GeorgeCao-001/Robotics-from-Scratch/arduino/MG513XP28_12V_接线指南.md

/*
 * ============================================================
 * 两驱小车完整接线指南
 * ============================================================
 * 电机型号: MG513XP28_12V (WHEELTEC 带霍尔编码器直流减速电机)
 * 驱动模块: TB6612FNG 双路H桥电机驱动 (A口+B口)
 * 电机连接: 左电机→A口, 右电机→B口
 * 控制平台: Arduino UNO
 * ============================================================
 */

/*
 * ------------------------------------------------------------------
 * 一、MG513XP28_12V 电机接口说明
 * ------------------------------------------------------------------
 *
 * MG513XP28_12V 电机为6线集成接口，包含：
 * 
 *  接口序号 | 功能说明       | 典型线色       | 电压等级
 *  --------|---------------|---------------|----------
 *  1       | 电机电源+     | 红色          | 12V
 *  2       | 电机电源-     | 黑色          | GND
 *  3       | 编码器VCC     | 白色/红色     | 3.3V~5V
 *  4       | 编码器GND     | 白色/黑色     | GND
 *  5       | 编码器信号A   | 黄色          | 开漏输出
 *  6       | 编码器信号B   | 绿色/蓝色     | 开漏输出
 *
 * 注意:
 *  - 6线接口为集成设计，无法分离，需整体连接
 *  - 编码器为双端输出(A相+B相)，支持方向检测
 *  - A相用于脉冲计数(外部中断)，B相用于方向判断
 *  - A/B相输出相差90°，A相上升沿时B相电平决定转向:
 *    B=LOW → 正转, B=HIGH → 反转
 *
 * ------------------------------------------------------------------
 * 二、TB6612 双路电机驱动模块说明
 * ------------------------------------------------------------------
 *
 * 模块集成一颗TB6612FNG芯片，提供2个独立电机端口(A/B):
 *
 *   TB6612 (单芯片): 控制A口 + B口
 *
 * 每个端口包含3个控制引脚:
 *   - PWM: 速度控制 (PWM信号)
 *   - IN1: 方向控制1
 *   - IN2: 方向控制2
 *
 * 本项目中:
 *   - 左电机 → 模块A口
 *   - 右电机 → 模块B口
 *
 * TB6612 控制真值表 (单路电机):
 *   IN1  | IN2  | PWM   | 电机状态
 *   -----|------|-------|----------
 *   0    | 0    | X     | 停止(制动)
 *   0    | 1    | 0~255 | 正转
 *   1    | 0    | 0~255 | 反转
 *   1    | 1    | X     | 停止(制动)
 *
 * ------------------------------------------------------------------
 * 三、MG513XP28_12V 与 TB6612 接线表
 * ------------------------------------------------------------------
 *
 *  左电机(L) → 模块A口 (TB6612):
 *
 *  左电机接口    | 模块A口引脚   | Arduino引脚   | 说明
 *  -------------|--------------|--------------|-------------------
 *  电机电源+     | AO1          | -            | 左电机电源正极
 *  电机电源-     | AO2          | -            | 左电机电源负极
 *  编码器VCC     | -            | 5V           | 编码器供电
 *  编码器GND     | -            | GND          | 编码器地
 *  编码器信号A   | -            | D2 (INT0)    | 左编码器A相脉冲
 *  编码器信号B   | -            | A4           | 左编码器B相方向
 *
 *  右电机(R) → 模块B口 (TB6612):
 *
 *  右电机接口    | 模块B口引脚   | Arduino引脚   | 说明
 *  -------------|--------------|--------------|-------------------
 *  电机电源+     | BO1          | -            | 右电机电源正极
 *  电机电源-     | BO2          | -            | 右电机电源负极
 *  编码器VCC     | -            | 5V           | 编码器供电
 *  编码器GND     | -            | GND          | 编码器地
 *  编码器信号A   | -            | D3 (INT1)    | 右编码器A相脉冲
 *  编码器信号B   | -            | A5           | 右编码器B相方向
 *
 *  模块控制信号   | Arduino引脚   | 说明
 *  ---------------|--------------|-------------------
 *  A口 PWMA      | D9 (PWM)     | 左电机PWM (A口)
 *  A口 AIN1      | D7           | 左电机方向1 (A口)
 *  A口 AIN2      | D6           | 左电机方向2 (A口)
 *  B口 PWMB      | D10 (PWM)    | 右电机PWM (B口)
 *  B口 BIN1      | D8           | 右电机方向1 (B口)
 *  B口 BIN2      | D12          | 右电机方向2 (B口)
 *  STBY          | D4           | 待机控制
 *  VCC           | 5V           | 逻辑电源
 *  GND           | GND          | 公共地
 *  VM            | 12V电池正极  | 电机电源输入
 *
 * ------------------------------------------------------------------
 * 四、电路检查清单
 * ------------------------------------------------------------------
 *
 * 【上电前必查】
 *
 * 1. 电源检查:
 *  [ ] 12V电池正极 → 模块VM (仅电机电源)
 *  [ ] 12V电池负极 → 模块GND + Arduino GND (共地)
 *  [ ] Arduino 5V → 模块VCC (逻辑电源)
 *  [ ] 严禁将12V接入Arduino 5V引脚
 *
 * 2. 电机输出检查:
 *  [ ] 左电机+ → 模块A口 AO1
 *  [ ] 左电机- → 模块A口 AO2
 *  [ ] 右电机+ → 模块B口 BO1
 *  [ ] 右电机- → 模块B口 BO2
 *  [ ] 电机线无短路 (万用表测量AO1-AO2、BO1-BO2)
 *
 * 3. 编码器检查:
 *  [ ] 左编码器VCC → Arduino 5V
 *  [ ] 左编码器GND → Arduino GND
 *  [ ] 左编码器信号A → Arduino D2
 *  [ ] 左编码器信号B → Arduino A4
 *  [ ] 右编码器VCC → Arduino 5V
 *  [ ] 右编码器GND → Arduino GND
 *  [ ] 右编码器信号A → Arduino D3
 *  [ ] 右编码器信号B → Arduino A5
 *
 * 4. 控制信号检查:
 *  [ ] PWMA (D9) → 模块A口 PWMA
 *  [ ] AIN1 (D7) → 模块A口 AIN1
 *  [ ] AIN2 (D6) → 模块A口 AIN2
 *  [ ] PWMB (D10) → 模块B口 PWMB
 *  [ ] BIN1 (D8) → 模块B口 BIN1
 *  [ ] BIN2 (D12) → 模块B口 BIN2
 *  [ ] STBY (D4) → 模块STBY
 *
 * 5. 共地检查:
 *  [ ] 模块GND ↔ Arduino GND ↔ 电池负极 (必须全部连通)
 *
 * ------------------------------------------------------------------
 * 五、接线验证步骤
 * ------------------------------------------------------------------
 *
 * 步骤1: 电源验证 (仅接电源, 不接电机)
 *   - 万用表测量模块VM-GND: 应显示12V左右
 *   - 万用表测量模块VCC-GND: 应显示5V
 *   - 确认无短路后进行下一步
 *
 * 步骤2: 编码器信号验证 (接编码器, 手转电机)
 *   - 将编码器A相信号引脚连接到Arduino D2/D3
 *   - 将编码器B相信号引脚连接到Arduino A4/A5
 *   - 手转电机轴, 用示波器或串口打印观察脉冲
 *   - 确认A相有脉冲输出
 *   - 确认A/B相相位差约90° (正转时A超前B, 反转时B超前A)
 *
 * 步骤3: 电机驱动验证 (电机悬空)
 *   - 上传测试程序, 发送命令使电机转动
 *   - 观察电机转向是否正确
 *   - 确认两个电机独立可控
 *
 * 步骤4: 闭环控制验证
 *   - 运行完整程序, 观察编码器读数
 *   - 确认PID控制正常工作
 *
 * ------------------------------------------------------------------
 * 六、驱动程序配置建议
 * ------------------------------------------------------------------
 *
 * MG513XP28_12V 电机关键参数 (需根据实际型号调整):
 * 
 *  电机参数       | 典型值       | 说明
 *  -------------|-------------|-------------------
 *  额定电压      | 12V         | 锂电池组供电
 *  减速比        | 1:28/1:30   | 常见配置, 影响转速
 *  编码器线数    | 11线        | 霍尔编码器分辨率
 *  编码器脉冲/圈 | 11 (A相上升沿) | 单倍频计数
 *
 * 程序配置建议:
 *
 * 1. 修改编码器脉冲数:
 *    #define ENCODER_PPR     11    // A相上升沿计数 (单倍频)
 *
 * 2. 调整PID参数 (MG513电机响应特性):
 *    #define VELOCITY_KP     18.0f  // 比例系数
 *    #define VELOCITY_KI     8.0f   // 积分系数
 *
 * 3. 调整默认速度:
 *    #define DEFAULT_SPEED   25     // 编码器脉冲/5ms
 *    #define DEFAULT_TURN    15     // 转向差速
 *
 * 4. 电机方向调整:
 *    如果电机转向相反, 可交换电机线(M+/M-)或修改代码:
 *    在setMotorPwm()函数中交换IN1/IN2的高低电平
 *
 * ------------------------------------------------------------------
 * 七、常见问题排查
 * ------------------------------------------------------------------
 *
 * 问题1: 电机不转
 *   - 检查STBY引脚是否为HIGH
 *   - 检查电机线连接是否正确 (左电机→A口, 右电机→B口)
 *   - 检查12V电源是否正常
 *   - 检查TB6612的STBY是否已拉高
 *
 * 问题2: 编码器无读数
 *   - 检查编码器VCC/GND连接
 *   - 检查信号引脚是否正确连接到D2/D3
 *   - 手转电机轴, 用示波器观察脉冲
 *
 * 问题3: 电机抖动或噪音大
 *   - 检查PID参数是否合适
 *   - 检查电源是否稳定 (加滤波电容)
 *   - 检查电机机械安装是否牢固
 *
 * 问题4: 小车走偏
 *   - 检查两个电机参数是否一致
 *   - 调整PID参数使转速匹配
 *   - 检查车轮安装是否对称
 *
 * ------------------------------------------------------------------
 * 八、接线示意图 (文字版)
 * ------------------------------------------------------------------
 *
 * 电源部分:
 *   [12V锂电池] ──→ [模块VM]
 *   [12V锂电池] ──→ [Arduino VIN] (可选)
 *   [电池负极] ──→ [模块GND] ──→ [Arduino GND]
 *
 * 左电机 → 模块A口:
 *   [左电机6线接口]
 *     ├─ 电机+ ──→ [模块A口 AO1]
 *     ├─ 电机- ──→ [模块A口 AO2]
 *     ├─ 编码器VCC ──→ [Arduino 5V]
 *     ├─ 编码器GND ──→ [Arduino GND]
 *     ├─ 编码器A相 ──→ [Arduino D2]
 *     └─ 编码器B相 ──→ [Arduino A4]
 *
 * 右电机 → 模块B口:
 *   [右电机6线接口]
 *     ├─ 电机+ ──→ [模块B口 BO1]
 *     ├─ 电机- ──→ [模块B口 BO2]
 *     ├─ 编码器VCC ──→ [Arduino 5V]
 *     ├─ 编码器GND ──→ [Arduino GND]
 *     ├─ 编码器A相 ──→ [Arduino D3]
 *     └─ 编码器B相 ──→ [Arduino A5]
 *
 * 控制信号:
 *   [Arduino D9]  ──→ [模块A口 PWMA]
 *   [Arduino D7]  ──→ [模块A口 AIN1]
 *   [Arduino D6]  ──→ [模块A口 AIN2]
 *   [Arduino D10] ──→ [模块B口 PWMB]
 *   [Arduino D8]  ──→ [模块B口 BIN1]
 *   [Arduino D12] ──→ [模块B口 BIN2]
 *   [Arduino D4]  ──→ [模块STBY]
 *   [Arduino 5V]  ──→ [模块VCC]
 *
 * ------------------------------------------------------------------
 * 九、12V锂电池组电源接入
 * ------------------------------------------------------------------
 *
 * 电源拓扑:
 *
 *   [12V锂电池组]
 *        |
 *        +----→ 模块VM (电机电源, 12V)
 *        |
 *        +----→ Arduino VIN (通过Arduino板载稳压器降压到5V)
 *        |      或通过USB单独供电Arduino
 *        |
 *        +----→ GND (共地!!!)
 *
 * 供电方案 (推荐方案A):
 *
 *   方案A: 12V电池同时供电Arduino和模块
 *     - 12V电池正极 → 模块VM
 *     - 12V电池正极 → Arduino VIN (板载稳压器降压到5V)
 *     - 12V电池负极 → 模块GND + Arduino GND (共地)
 *     - Arduino 5V → 模块VCC (逻辑电源)
 *
 *   方案B: 12V电池供电模块, USB供电Arduino (调试推荐)
 *     - 12V电池正极 → 模块VM
 *     - 12V电池负极 → 模块GND
 *     - Arduino USB供电
 *     - Arduino 5V → 模块VCC
 *     - 模块GND ↔ Arduino GND (必须共地!!!)
 *
 * 注意事项:
 *   1. 12V电池组务必使用3S锂电池(标称11.1V, 满电12.6V)
 *   2. 模块VM最高耐压15V, 3S锂电池安全可用
 *   3. 严禁将12V直接接入Arduino 5V引脚, 会烧毁芯片!
 *   4. 必须确保所有GND共地, 否则信号无法正常传输
 *   5. 建议在VM和GND之间并联100μF~470μF电解电容, 吸收电机反电动势
 *   6. 电池正极建议串联5A保险丝, 防止短路
 *   7. 首次上电前用万用表确认无短路
 *
 * ------------------------------------------------------------------
 * 十、万向轮机械安装简要说明
 * ------------------------------------------------------------------
 *
 * 三轮结构布局 (俯视图):
 *
 *          [万向轮]
 *             |
 *     --------O--------    ← 前部
 *     |                |
 *     |    车体底盘    |
 *     |                |
 *     -----O-----O----    ← 后部
 *        [左轮] [右轮]
 *
 * 安装要点:
 *   1. 万向轮安装在车体前部中央, 作为从动支撑轮
 *   2. 两个驱动轮安装在车体后部左右两侧
 *   3. 万向轮高度需与驱动轮在同一水平面, 确保车体平稳
 *   4. 万向轮选用球型或牛眼轮(ball caster), 摩擦力小
 *   5. 驱动轮轴心连线应与万向轮安装点形成等腰三角形
 *   6. 重心应尽量靠近驱动轮轴心连线, 避免万向轮承重过大
 *   7. 万向轮安装座需有足够强度, 推荐使用金属支架
 *   8. 建议在万向轮与底盘之间加装弹簧或橡胶垫, 吸收震动
 *
 * ------------------------------------------------------------------
 * 十一、首次运行步骤
 * ------------------------------------------------------------------
 *
 *  1. 仅通过USB连接Arduino到电脑 (不接12V电池)
 *  2. 上传程序到Arduino UNO
 *  3. 打开串口监视器 (波特率115200)
 *  4. 确认看到初始化信息
 *  5. 断开USB, 按接线图连接12V电池
 *  6. 将小车悬空 (车轮离地), 重新连接USB
 *  7. 在串口发送 'w' 命令, 观察车轮是否转动
 *  8. 确认两个车轮转动方向正确 (都向前转)
 *  9. 如果某车轮反转, 交换该电机M+/M-接线
 *  10. 确认编码器读数正常 (串口会打印编码器值)
 *  11. 所有测试通过后, 将小车放置地面运行
 *
 * ============================================================
 */
