GeorgeCao-001/Robotics-from-Scratch/arduino/logs/changelog/2026-05-12/wiring_guide.md

================================================================================
  遥控器系统接线指南 - 每日更新日志
================================================================================

项目名称: 遥控器系统接线指南 (遥控器系统接线指南.md)
版本号:   v2.0.0
更新日期: 2026-05-12

================================================================================
一、主要更新内容
================================================================================

【新增内容】
  - 新增控制方式说明: 左摇杆Y轴=速度、右摇杆X轴=方向、模式按键=手动/自动
  - 新增摇杆单轴接线说明(左摇杆仅Y轴、右摇杆仅X轴，其余悬空)
  - 新增控制模式详细说明章节(第八节)
    - 手动控制模式操作说明
    - 自动运行模式操作说明
    - LED状态指示含义
  - 新增自动模式故障排除条目
  - 新增UART协议示例(含自动模式示例: "$V0,T0,F1*\n")

【优化项】
  - 元件清单精简: 移除SG90/MG90S舵机、4个按键减为1个、移除蜂鸣器
  - ESP32-S3接线表精简: 从12个引脚减至6个
  - ESP32-C3接线表精简: 移除舵机引脚(GPIO7/GPIO8)和电池ADC(GPIO0)
  - ESP-NOW数据包格式图更新为6字节
  - UART协议格式更新: 移除S字段
  - 测试步骤更新: 增加模式切换测试、移除云台测试
  - 系统架构图更新: 反映新的控制方式

【移除内容】
  - 移除云台舵机相关接线说明(GPIO7/GPIO8)
  - 移除急停/加速/减速按键接线说明
  - 移除蜂鸣器接线说明
  - 移除ESP32-C3电池ADC检测电路说明
  - 移除云台测试步骤(阶段5)
  - 移除舵机抖动故障排除条目
  - 移除旧版9字节数据包格式图

================================================================================
二、影响范围
================================================================================

  文档影响:
    - 接线指南全面重写，与v1.x内容差异较大
    - 硬件搭建需完全参照v2.0版本

  硬件搭建影响:
    - 遥控器元件数量减少，组装更简单
    - ESP32-C3接线更简单(仅需4线)
    - 不再需要舵机供电考虑

================================================================================
三、兼容性说明
================================================================================

  文档兼容: 仅适用于v2.0.0固件
    - v1.x固件请参照旧版接线指南
    - 固件与接线指南版本必须匹配

  硬件参考:
    - ESP32-S3 DevKitC: 引脚定义适用
    - ESP32-C3 SuperMini: 引脚定义适用
    - KY-023摇杆模块: 接线方式适用(单轴接法)

================================================================================
四、已知问题
================================================================================

  1. 左摇杆VRx和右摇杆VRy悬空可能导致ADC输入浮动，
     建议在PCB设计时将未用ADC引脚接地或接3.3V

  2. 文档中ESP32-C3的电池电压检测已移除，
     但StatusPacket中仍有batteryVx10字段，
     该字段当前回传固定值，后续版本需补充说明

  3. 1kΩ串联电阻保护ESP32-C3 RX引脚的说明较为简略，
     建议后续版本增加电路原理图

================================================================================
