GeorgeCao-001/Robotics-from-Scratch/arduino/logs/changelog/2026-05-14/wiring_guide.md

================================================================================
  项目文档 - 每日更新日志
================================================================================

项目名称: 技术文档与遥控器系统接线指南 (技术文档.md / 遥控器系统接线指南.md)
版本号:   v2.2.0
更新日期: 2026-05-14

================================================================================
一、主要更新内容
================================================================================

【修复的问题】
  - 修正文档中"收到普通遥控指令后自动切换到遥控器模式"的旧描述
    现统一更正为: 仅在用户按下模式键并发送显式切换请求时才执行模式切换

  - 修正文档中flags字段的旧定义
    原说明为"bit0=自动模式"
    现更新为"bit0=当前模式, bit1=模式切换请求"

  - 修正UART协议示例中的旧模式切换写法
    旧示例: "$V0,T0,F1*\n"
    新示例: "$V0,T0,F3*\n" (切换到自动模式)
            "$V0,T0,F2*\n" (切换到手动模式)

【优化项】
  - 技术文档中的三模式控制系统说明与最新主控实现保持一致
  - 遥控器系统接线指南补充"自动模式下拨动摇杆不会自动切回手动"测试项
  - 两份文档的协议术语、模式定义与示例格式已统一

================================================================================
二、影响范围
================================================================================

  文档影响:
    - 技术文档中的协议说明、模式流转图、解析逻辑说明已同步更新
    - 遥控器系统接线指南中的协议图示、操作说明、测试步骤已同步更新

  使用影响:
    - 使用者可准确区分"当前模式状态"与"模式切换请求"
    - 调试与联调时可直接依据新flags示例定位模式切换问题

================================================================================
三、兼容性说明
================================================================================

  文档适用范围:
    - 适用于遥控器v2.1.0与Arduino主控v2.1.0的组合
    - ESP32-C3接收器v2.0.x/v2.1.x均可参考相同协议说明

  版本建议:
    - 若项目仍停留在v2.0.x，请勿直接套用本次模式切换示例
    - 建议代码与文档同步升级，避免调试时出现认知偏差

================================================================================
四、已知问题
================================================================================

  (无新增)

================================================================================
五、v2.2.0 追加更新 (2026-05-14)
================================================================================

【修复的问题】
  - 修正遥控器系统接线指南中UART协议回传格式描述
    原描述: "#E<encL>,<encR>,<pwmA>,<pwmD>,\n"
    现更正: "#E<encL>,<encR>,<pwmA>,<pwmB>,\n"
    与主控代码中motorPwmB变量命名保持一致

================================================================================
六、v2.3.0 追加更新 (2026-05-14)
================================================================================

【新增内容】
  - 接线指南全面更新为6线编码器接口
    新增编码器B相信号线(序号6, 绿色/蓝色)
  - 接线表新增B相行: 左编码器B→A4, 右编码器B→A5
  - 电路检查清单新增B相连接检查项
  - 接线验证步骤新增A/B相相位差验证
  - 接线示意图从5线更新为6线

【修复的问题】
  - 修正编码器脉冲/圈说明
    原说明"44 (11×4) 4倍频后脉冲数"与实际1倍频计数不一致
    现修正为"11 (A相上升沿) 单倍频计数"

【优化项】
  - 遥控器系统接线指南Arduino引脚分配表新增A4/A5编码器B相行
  - D2/D3功能描述从"编码器左/右"更精确为"编码器左A相/右A相"

================================================================================
