GeorgeCao-001/Robotics-from-Scratch/arduino/logs/changelog/2026-05-13/wiring_guide.md

================================================================================
  接线指南文档 - 每日更新日志
================================================================================

项目名称: 两驱小车完整接线指南 (MG513XP28_12V_接线指南.md)
版本号:   v2.0.1
更新日期: 2026-05-13

================================================================================
一、主要更新内容
================================================================================

【新增内容】
  - 合并接线指导.md的3节唯一内容至本文档:
    九、12V锂电池组电源接入 (含电源拓扑、方案A/B、7条注意事项)
    十、万向轮机械安装简要说明 (含三轮布局图、8条安装要点)
    十一、首次运行步骤 (11步首次运行流程)

【优化项】
  - 文件标题从"MG513XP28_12V 电机 - WHEELTEC四路TB6612 驱动接线指南"
    更新为"两驱小车完整接线指南"，更准确反映综合接线文档定位
  - 章节编号从8节扩展为11节，结构更完整

【移除内容】
  - 删除冗余文件 接线指导.md (内容已合并至本文档)

================================================================================
二、影响范围
================================================================================

  文档影响:
    - 接线指导.md已删除，所有接线信息统一由MG513XP28_12V_接线指南.md提供
    - 文档从8节(250行)扩展为11节(329行)

  开发影响:
    - 开发人员仅需查阅一个接线文档，避免信息分散和版本不一致

================================================================================
三、兼容性说明
================================================================================

  技术内容: 与v2.0.0完全一致
    - 引脚分配、接线方式、电机连接均无变更
    - 新增内容来自已删除的接线指导.md，为原有内容的迁移

================================================================================
四、已知问题
================================================================================

  (无新增)

================================================================================
