GeorgeCao-001/Robotics-from-Scratch/arduino/logs/changelog/2026-05-16/daily_summary.md

================================================================================
  项目每日工作总结日志
================================================================================

项目名称: Arduino TB6612 两驱小车 + 树莓派4B视觉跟随系统
工作日期: 2026-05-16
记录时间: 2026-05-16

================================================================================
一、今日完成任务总览
================================================================================

  | 序号 | 任务名称 | 状态 | 优先级 |
  |------|---------|------|--------|
  | 1 | 遥控模式转向方向修正 | ✅ 完成 | 高 |
  | 2 | 遥控模式转向速度调整 | ✅ 完成 | 高 |
  | 3 | 树莓派4B硬件连接方案设计 | ✅ 完成 | 高 |
  | 4 | Arduino端树莓派自动模式实现 | ✅ 完成 | 高 |
  | 5 | 树莓派端代码适配与模式切换 | ✅ 完成 | 高 |
  | 6 | 失控急停多层保护完善 | ✅ 完成 | 高 |
  | 7 | 技术文档全面更新 | ✅ 完成 | 高 |
  | 8 | 更新日志创建 | ✅ 完成 | 中 |

================================================================================
二、任务详细记录
================================================================================

  ──────────────────────────────────────────
  任务1: 遥控模式转向方向修正
  ──────────────────────────────────────────
  开始时间: 2026-05-16 上午
  结束时间: 2026-05-16 上午
  任务成果:
    - 在applyRemoteDrive()中添加 steerPercent = -steerPercent
    - 遥控器向左操作→小车左转，向右操作→小车右转
  实施步骤:
    1. 分析转向方向反转的根本原因：摇杆映射百分比与差速驱动方向定义相反
    2. 在applyRemoteDrive()中转向百分比取反
    3. 实际操作测试验证方向正确性
  遇到问题: 无
  解决方案: N/A
  使用技术/工具: C++、Arduino IDE

  ──────────────────────────────────────────
  任务2: 遥控模式转向速度调整
  ──────────────────────────────────────────
  开始时间: 2026-05-16 上午
  结束时间: 2026-05-16 上午
  任务成果:
    - REMOTE_TURN_PWM_MAX从200降低到80
    - 转向速度平稳可控，不再过快
  实施步骤:
    1. 确认转向速度过快的根本原因：PWM上限过高
    2. 逐步降低PWM上限，从200→120→80，测试转向手感
    3. 最终确定80为最佳值，转向平稳且响应灵敏
  遇到问题: 初始尝试120仍然偏快
  解决方案: 继续降低到80，达到理想手感
  使用技术/工具: C++、Arduino IDE、实际操作测试

  ──────────────────────────────────────────
  任务3: 树莓派4B硬件连接方案设计
  ──────────────────────────────────────────
  开始时间: 2026-05-16 上午
  结束时间: 2026-05-16 下午
  任务成果:
    - USB串口直连方案: 树莓派USB-A → Arduino UNO USB-B
    - 不占用任何Arduino已有引脚
    - 云台舵机连接树莓派GPIO17(水平)/GPIO27(垂直)
    - 供电方案: 2S电池→UBEC(5V/3A)→树莓派，与Arduino共地
  实施步骤:
    1. 盘点Arduino UNO已占用引脚(D2~D13, A0~A5全部已用)
    2. 确认USB CDC虚拟串口方案无需额外引脚
    3. 设计树莓派GPIO引脚分配(BCM17/27用于舵机PWM)
    4. 设计供电方案(UBEC降压，避免树莓派USB供电不足)
    5. 编写详细硬件连接文档
  遇到问题: Arduino引脚全部已占用，无法使用UART/I2C/SPI
  解决方案: 利用USB CDC虚拟串口，无需额外引脚
  使用技术/工具: USB CDC协议、RPi.GPIO、UBEC降压模块

  ──────────────────────────────────────────
  任务4: Arduino端树莓派自动模式实现
  ──────────────────────────────────────────
  开始时间: 2026-05-16 下午
  结束时间: 2026-05-16 下午
  任务成果:
    - 新增CTRL_MODE_RPI_AUTO(3)控制模式
    - 实现parseRpiCommand() JSON指令解析
    - 实现JSON缓冲区机制(64字节)
    - 实现checkRpiTimeout()超时检测(1000ms)
    - handleSerialCommand()重构为双通道处理
  实施步骤:
    1. 定义CTRL_MODE_RPI_AUTO常量和相关全局变量
    2. 实现JSON缓冲区逐字符接收逻辑
    3. 实现parseRpiCommand()解析move/mode/estop/stop四种指令
    4. 实现v/w归一化值到Arduino速度/转向脉冲的映射
    5. 实现checkRpiTimeout()超时停车检测
    6. 修改handleSerialCommand()支持单字符和JSON双通道
    7. 修改parseRemoteCommand()支持RPI_AUTO模式切换
  遇到问题:
    - JSON解析与单字符命令共存需要区分机制
  解决方案:
    - 以'{'开头识别JSON指令，其他为单字符命令
    - 仅在RPI_AUTO模式下解析JSON，其他模式仅处理单字符
  使用技术/工具: C++、Arduino串口编程、JSON简易解析(strstr)

  ──────────────────────────────────────────
  任务5: 树莓派端代码适配与模式切换
  ──────────────────────────────────────────
  开始时间: 2026-05-16 下午
  结束时间: 2026-05-16 下午
  任务成果:
    - main.py启动流程增加mode:rpi_auto切换指令
    - main.py退出流程增加mode:remote恢复指令
    - serial_comm.py新增mode和estop指令验证
    - 所有退出操作用try/except包裹确保资源释放
  实施步骤:
    1. 在main.py的run()函数中添加启动模式切换
    2. 在main.py的finally块中添加退出模式恢复
    3. 在serial_comm.py的_validate_message()中添加mode/estop验证
    4. 测试启动/退出流程的可靠性
  遇到问题: 退出时串口可能已断开导致发送失败
  解决方案: 所有退出操作用try/except包裹，不阻塞后续资源清理
  使用技术/工具: Python、pyserial、RPi.GPIO

  ──────────────────────────────────────────
  任务6: 失控急停多层保护完善
  ──────────────────────────────────────────
  开始时间: 2026-05-16 下午
  结束时间: 2026-05-16 下午
  任务成果:
    - 建立6层失控急停保护体系:
      1. 树莓派超时急停(1000ms)
      2. 视觉丢失停车(0.8s)
      3. 遥控器急停(模式键)
      4. USB串口急停(空格/estop)
      5. 树莓派退出(finally块)
      6. 树莓派断电(USB断开)
    - 明确保护优先级: estop > 遥控器 > 超时 > 视觉丢失
    - 区分"切换模式"和"仅停车"两种响应级别
  实施步骤:
    1. 梳理所有可能的失控场景
    2. 为每种场景设计检测机制和响应策略
    3. 确定保护优先级和恢复方式
    4. 在代码中实现各层保护逻辑
  遇到问题: 超时停车后是否应切换模式
  解决方案: 超时和视觉丢失仅停车不切换模式，允许自动恢复；
           estop和遥控器模式键切换模式，需手动恢复
  使用技术/工具: C++、Python、millis()超时检测

  ──────────────────────────────────────────
  任务7: 技术文档全面更新
  ──────────────────────────────────────────
  开始时间: 2026-05-16 下午
  结束时间: 2026-05-16 晚间
  任务成果:
    - 新增2.5硬件连接方案章节(5个子章节)
    - 新增2.6树莓派端代码解析章节(5个子章节)
    - 更新项目目标、功能模块图、模式控制、JSON解析、安全保护等章节
    - 修正转向PWM上限值(120→80)
    - 术语表新增8个术语
    - 学习路径新增"阶段5: 视觉跟随"
    - 知识点对照表新增3行
    - 版本迭代记录更新至v2.2.0
  实施步骤:
    1. 审查现有文档，识别与代码不一致的章节
    2. 审查所有源代码文件，确认最新实现状态
    3. 更新系统架构与模式控制章节
    4. 更新串口通信协议与JSON指令解析章节
    5. 更新失控急停保护章节
    6. 新增树莓派端代码解析章节
    7. 更新硬件连接方案章节
    8. 更新使用说明与操作指南
    9. 同步更新变更日志与术语表
    10. 最终一致性校验(常量值、模式编号、命名)
  遇到问题:
    - 文档中REMOTE_TURN_PWM_MAX值(120)与代码(80)不一致
    - 2.4模块交互逻辑标题被误删
  解决方案:
    - 修正文档中的PWM上限值为80
    - 恢复2.4标题
  使用技术/工具: Markdown、代码审查

================================================================================
三、遇到的问题及解决方案汇总
================================================================================

  | 问题 | 影响 | 解决方案 | 状态 |
  |------|------|---------|------|
  | 遥控模式转向方向相反 | 操作直觉不符 | applyRemoteDrive()中steerPercent取反 | ✅ |
  | 转向速度过快 | 操控不稳定 | REMOTE_TURN_PWM_MAX从200降到80 | ✅ |
  | Arduino引脚全部已占用 | 无法用UART/I2C连接树莓派 | 使用USB CDC虚拟串口 | ✅ |
  | JSON与单字符命令共存 | 串口命令解析冲突 | 以'{'开头区分JSON，模式分流 | ✅ |
  | 退出时串口可能已断开 | 模式恢复指令发送失败 | try/except包裹，不阻塞清理 | ✅ |
  | 文档PWM上限值不一致 | 文档误导 | 修正为与代码一致的80 | ✅ |
  | 2.4标题被误删 | 文档结构不完整 | 恢复### 2.4标题 | ✅ |

================================================================================
四、未完成事项及原因分析
================================================================================

  (无未完成事项)

  今日计划的所有任务均已完成。

================================================================================
五、技术决策记录
================================================================================

  1. USB串口 vs GPIO串口连接树莓派
     决策: 使用USB CDC虚拟串口
     原因: Arduino UNO所有引脚已占用，USB串口无需额外引脚；
           115200bps速率充足，USB CDC稳定性优于SoftwareSerial

  2. JSON简易解析 vs ArduinoJson库
     决策: 使用strstr()简易解析
     原因: Arduino UNO RAM仅2KB，ArduinoJson库占用较多内存；
           当前指令格式均为扁平结构，strstr()足够

  3. 超时停车是否切换模式
     决策: 超时和视觉丢失仅停车不切换模式
     原因: 允许树莓派恢复后自动继续控制，避免频繁模式切换；
           estop和遥控器模式键切换模式，用于需要手动接管的场景

  4. 转向PWM上限值选择
     决策: REMOTE_TURN_PWM_MAX = 80
     原因: 120仍偏快，80在测试中达到平稳可控的转向手感；
           远低于驱动PWM上限220，确保转向不会过于剧烈

================================================================================
六、明日工作计划
================================================================================

  1. 树莓派自动模式实车联调测试
     - 验证USB串口通信稳定性
     - 验证视觉跟随效果
     - 验证6层急停保护的实际响应

  2. 参数微调
     - 根据实车测试结果调整PlanningConfig参数
     - 可能需要调整kp_angle/kp_distance/v_max/w_max

  3. 补充实物接线照片到技术文档
     - 拍摄树莓派与Arduino的USB连接
     - 拍摄云台舵机接线
     - 拍摄UBEC供电接线

  4. 性能优化（如需要）
     - 评估MediaPipe在树莓派4B上的实际帧率
     - 评估是否需要降低模型复杂度

================================================================================
七、工作时长统计
================================================================================

  | 任务类别 | 预估时长 | 实际时长 |
  |---------|---------|---------|
  | 遥控模式调试 | 1h | 1h |
  | 硬件方案设计 | 2h | 2h |
  | Arduino代码开发 | 3h | 3h |
  | 树莓派代码适配 | 1h | 1h |
  | 安全保护完善 | 1h | 1h |
  | 技术文档更新 | 3h | 3h |
  | 更新日志编写 | 1h | 1h |
  | 合计 | 12h | 12h |

================================================================================
