GeorgeCao-001/Robotics-from-Scratch/arduino/logs/changelog/2026-05-16/documentation.md

================================================================================
  项目技术文档 - 每日更新日志
================================================================================

项目名称: 技术文档 (技术文档.md)
版本号:   v2.2.0
更新日期: 2026-05-16

================================================================================
一、主要更新内容
================================================================================

【新增章节】

  1. 2.5 树莓派4B硬件连接方案
     - USB串口直连方案: 树莓派4B USB-A → Arduino UNO USB-B
     - 引脚分配表: 树莓派GPIO17(水平舵机)/GPIO27(垂直舵机)/USB串口
     - 供电方案: 2S锂电池→UBEC(5V/3A)→树莓派4B，与Arduino共地
     - 通信协议: JSON over Serial, 115200bps, '\n'分隔
     - 接线注意事项: USB数据线要求、共地连接、舵机供电隔离

  2. 2.6 树莓派端代码解析
     - 2.6.1 项目结构: 目录树 + 各模块职责说明
     - 2.6.2 串口通信模块: SerialComm类、参数选择依据、白名单验证、发送流程
     - 2.6.3 云台控制模块: GimbalHardware类、角度→占空比映射推导、舵机PWM原理
     - 2.6.4 规划模块: PlanningConfig参数、P控制设计理由、Planner协调器、
       FollowController(v/w计算)、GimbalController(增量式控制)
     - 2.6.5 主程序生命周期: 线程模型、分线程原因、命令行参数

【更新章节】

  1. 项目目标
     - 新增"视觉跟随"目标: 树莓派4B + 摄像头实现人体检测与自动跟随
     - 新增"云台控制"目标: 树莓派GPIO PWM驱动双轴云台，摄像头始终对准目标
     - 新增"安全保护"目标: 电池低压保护、遥控器断连自动停车、树莓派超时急停、视觉丢失停车

  2. 系统功能模块图
     - 新增树莓派相关模块: 摄像头、视觉处理(MediaPipe Pose)、
       USB串口通信、云台PWM控制

  3. 模式控制章节
     - "三模式控制系统"更新为"四模式控制系统"
     - 新增树莓派自动模式(编号3): 触发方式、行为描述、切换逻辑
     - 更新模式切换流程图: 包含自动模式的进入和退出路径

  4. 2.3.4 JSON指令解析
     - 新增parseRpiCommand()完整代码解析
     - 新增JSON缓冲区机制说明(rpiBuf[64], 逐字符接收, '\n'分隔)
     - 新增v/w→Arduino速度映射公式:
       velocity = v × REMOTE_SPEED_MAX (40脉冲/5ms)
       turn = w × DEFAULT_TURN (18脉冲/5ms)
     - 新增超时检测checkRpiTimeout()说明

  5. 2.4.3 树莓派自动模式流程
     - 扩展为启动阶段+退出阶段双流程图
     - 新增启动/退出关键设计说明(先停车再切换模式、try/except包裹)
     - 安全保护表从5层扩展为6层(新增"树莓派断电"保护)
     - 新增"恢复方式"列和"保护优先级"说明

  6. 目录
     - 新增2.5和2.6章节链接

  7. 术语表
     - 新增8个术语: P控制、JSON、MediaPipe、BCM编号、USB CDC、UBEC、指数平滑、daemon线程
     - 修正PWM解释: "控制电机平均电压" → "控制电机平均电压或舵机角度"

  8. 学习路径
     - 新增"阶段5: 视觉跟随 (2~3周)"含5个子项

  9. 知识点对照表
     - 新增3行: 视觉检测(MediaPipe Pose)、嵌入式Python(树莓派)、舵机控制(GPIO PWM)
     - 通信协议更新: ESP-NOW+UART → ESP-NOW+UART+USB Serial

【修正项】

  1. 修正转向PWM上限值: 120 → 80 (与代码REMOTE_TURN_PWM_MAX=80一致)
  2. 修正版本记录v2.1.2: "200→120" → "200→80"
  3. 恢复2.4模块交互逻辑标题(此前被误删)
  4. 修正遥控器模式键切换目标: CTRL_MODE_DEMO → CTRL_MODE_RPI_AUTO

================================================================================
二、影响范围
================================================================================

  文档结构影响:
    - 文档从"Arduino+遥控器"双模块扩展为"Arduino+遥控器+树莓派"三模块
    - 新增2.5和2.6两个二级章节，共7个三级子章节
    - 术语表扩充约50%

  内容准确性影响:
    - 所有常量值与代码一致(REMOTE_SPEED_MAX=40, DEFAULT_TURN=18等)
    - 模式编号与代码定义一致(0/1/2/3)
    - 安全保护机制与实际实现一致(6层保护+优先级)

================================================================================
三、兼容性说明
================================================================================

  文档适用范围:
    - 适用于Arduino主控v2.4.0 + 树莓派v1.0.0 + 遥控器v2.1.0的组合
    - ESP32-C3接收器v2.0.x/v2.1.x均可参考

  版本建议:
    - 若项目未集成树莓派，2.5/2.6章节可暂不参考
    - 核心运动控制和遥控器章节与之前版本保持兼容

================================================================================
四、已知问题
================================================================================

  1. 树莓派端代码解析为概要级别，未包含逐行分析
     后续可根据需要补充vision/pose_landmarker.py的详细解析

  2. 硬件连接方案中未包含实物接线照片
     建议后续补充实际接线照片辅助理解

================================================================================
