GeorgeCao-001/Robotics-from-Scratch/arduino/logs/changelog/2026-05-14/car_receiver.md

================================================================================
  ESP32-C3 小车端接收器固件 - 每日更新日志
================================================================================

项目名称: ESP32-C3 小车端接收器固件 (car_receiver)
版本号:   v2.0.2
更新日期: 2026-05-14

================================================================================
一、主要更新内容
================================================================================

【验证通过项】
  - 验证接收器对扩展flags字段保持透明转发
    当前sendToArduino()与onRecv()均未对flags做位级裁剪，
    可兼容上游新增的FLAG_MODE_SWITCH_REQUEST(bit1)语义

【优化项】
  - 同步修正文档注释中flags字段定义
    从"bit0=自动模式"更新为
    "bit0=当前模式, bit1=模式切换请求"
    便于与遥控器端、Arduino主控端协议说明保持一致

================================================================================
二、影响范围
================================================================================

  代码影响:
    - 运行逻辑无变更
    - ESP-NOW接收、UART转发、状态回传流程保持不变

  协议影响:
    - 接收器继续作为透明桥接层工作
    - 可直接转发v2.1.0协议中的flags扩展位

================================================================================
三、兼容性说明
================================================================================

  与ESP32-S3遥控器兼容:
    - 兼容v2.0.x与v2.1.0
    - 不论flags是否包含bit1，接收器均可正常转发

  与Arduino UNO主控兼容:
    - 兼容v2.0.x与v2.1.0
    - 模式切换语义由Arduino主控解析，接收器无需同步逻辑改动

================================================================================
四、已知问题
================================================================================

  (继承v2.0.1已知问题，无新增)

  1. readFromArduino()仍使用String.readStringUntil()阻塞读取
  2. batteryVoltage默认值12.0V，但实际ADC检测功能正常工作
  3. 心跳超时停车后不会自动恢复

================================================================================
