GeorgeCao-001/Robotics-from-Scratch/arduino/logs/changelog/2026-05-12/car_receiver.md

================================================================================
  ESP32-C3 小车端接收器固件 - 每日更新日志
================================================================================

项目名称: ESP32-C3 小车端接收器固件 (car_receiver)
版本号:   v2.0.0
更新日期: 2026-05-12

================================================================================
一、主要更新内容
================================================================================

【新增功能】
  - 适配新的6字节ControlPacket数据包格式
  - 支持FLAG_AUTO_MODE(0x01)标志位解析与转发
  - 校验和计算适配新包结构(5字节范围)

【优化项】
  - UART转发格式精简: "$V%d,T%d,F%d*\n" (移除S字段)
  - 断连停车时发送flags=0而非FLAG_ESTOP，语义更清晰
  - 状态LED增加自动模式慢闪(800ms)指示
  - StatusPacket校验和计算改用sizeof(pkt)-1，更健壮

【移除功能】
  - 移除ESP32Servo库及所有舵机相关代码
  - 移除云台Pan舵机(GPIO7)和Tilt舵机(GPIO8)引脚定义
  - 移除initServos()、updateServos()函数
  - 移除panServo/tiltServo对象及panAngle/tiltAngle变量
  - 移除servoAttached标志及SERVO_CENTER/SERVO_RANGE常量
  - 移除PTZ_PAN_PIN/PTZ_TILT_PIN引脚定义
  - 移除FLAG_ESTOP/FLAG_PTZ_EN标志位定义
  - 移除sendToArduino()中的speed参数

================================================================================
二、影响范围
================================================================================

  硬件影响:
    - ESP32-C3不再需要连接舵机，GPIO7/GPIO8释放
    - 电池ADC检测电路(GPIO0)保留，用于电池电压回传
    - 需4根线连接Arduino UNO: TX(RX)、RX(TX)、VCC、GND

  软件影响:
    - 遥控器端需同步更新至v2.0.0
    - Arduino UNO主程序需同步更新以适配新UART格式
    - ControlPacket结构体与v1.x不兼容

  通信影响:
    - ESP-NOW接收包格式变更(9字节→6字节)
    - UART发送格式变更(移除S字段)
    - 心跳超时停车命令格式变更

================================================================================
三、兼容性说明
================================================================================

  向后兼容: 不兼容v1.x
    - 数据包结构变更，v2.0与v1.x无法互通
    - 必须将遥控器、接收器、Arduino主程序全部升级至v2.0

  硬件兼容:
    - ESP32-C3 SuperMini: 完全兼容
    - ESP32-C3 DevKitM: 完全兼容
    - 不再需要舵机供电

  协议兼容:
    - ESP-NOW通道: 保持通道1不变
    - UART波特率: 保持9600不变

================================================================================
四、已知问题
================================================================================

  1. readFromArduino()仍使用String.readStringUntil()阻塞读取，
     在高频率通信时可能影响主循环响应速度
     建议后续版本改为非阻塞逐字节解析

  2. 电池电压检测功能正常运行(checkBattery每2秒采样)，
     batteryVx10通过StatusPacket回传给遥控器，
     但ESP32-C3的ADC精度有限，电压读数可能有±0.2V偏差

  3. 心跳超时停车后不会自动恢复，需等待遥控器重新上线
     并发送新的控制指令才能恢复运动

================================================================================
