GeorgeCao-001/Robotics-from-Scratch/arduino/logs/changelog/2026-05-12/main_controller.md

================================================================================
  Arduino UNO 两驱小车控制程序 - 每日更新日志
================================================================================

项目名称: Arduino UNO 两驱小车控制程序 (Arduino_TB6612_TwoWheel_Car)
版本号:   v2.0.0
更新日期: 2026-05-12

================================================================================
一、主要更新内容
================================================================================

【新增功能】
  - 新增SoftwareSerial通信功能，通过D5(RX)/D11(TX)与ESP32-C3接收器通信
  - 新增三模式控制系统: 演示模式(DEMO)/串口命令模式(SERIAL)/遥控器模式(REMOTE)
  - 新增handleRemoteCommand()非阻塞串口命令解析函数
  - 新增parseRemoteCommand()遥控器指令解析，支持新协议格式
  - 新增checkRemoteTimeout()遥控器超时自动停车功能(500ms)
  - 新增sendEncoderFeedback()编码器数据回传功能(200ms周期)
  - 新增模式切换串口命令'M'，可在三种模式间循环切换
  - 新增遥控器自动检测：收到遥控指令时自动切换到REMOTE模式
  - 新增flags bit0=自动模式解析，遥控器可远程切换到演示模式

【优化项】
  - UART协议格式精简: "$V<vel>,T<turn>,F<flags>*\n" (移除S字段)
  - 速度映射从"档位×偏移"改为"摇杆偏移直接映射到REMOTE_SPEED_MAX"
  - parseRemoteCommand()采用非阻塞逐字节缓冲区解析，
    替代原readStringUntil()阻塞方式，避免影响PID控制周期
  - printStatus()增加控制模式和遥控器连接状态显示
  - loop()增加遥控器命令处理、超时检测和编码器回传逻辑
  - 初始化信息增加遥控器通信相关提示

【修复的问题】
  - 修复原handleRemoteCommand()使用readStringUntil()阻塞主循环的问题
    改为字符缓冲区+逐字节解析的非阻塞实现
  - 修复速度档位为0时maxSpeed为0导致map()输出异常的问题
    (已通过移除档位机制彻底解决)

【移除功能】
  - 移除remoteSpeedLevel变量及S字段解析
  - 移除FLAG_ESTOP急停标志解析，改为自动模式标志
  - 移除速度档位缩放逻辑(scaleFactor)

================================================================================
二、影响范围
================================================================================

  硬件影响:
    - 新增D5(SoftSerial RX)和D11(SoftSerial TX)引脚占用
    - 需确认D5/D11未与其他功能冲突(已验证无冲突)
    - 需连接ESP32-C3接收器(4线: TX/RX/VCC/GND)

  软件影响:
    - 新增SoftwareSerial库依赖
    - 主循环增加3个定时任务(遥控器处理/超时检测/编码器回传)
    - Timer2中断服务程序不受影响，PID控制周期保持5ms

  功能影响:
    - 串口命令'M'功能变更: 从"切换演示模式"改为"三模式循环切换"
    - 遥控器模式下演示序列不执行
    - 自动模式(遥控器触发)下执行演示序列

================================================================================
三、兼容性说明
================================================================================

  向后兼容: 不兼容v1.x的遥控器通信
    - UART协议格式变更(移除S字段)
    - flags含义变更(bit0: 急停→自动模式)
    - 必须与ESP32-C3接收器v2.0.0配合使用

  独立功能兼容:
    - USB串口命令控制: 完全兼容，新增'M'命令
    - 演示模式: 完全兼容
    - PID电机控制: 不受影响
    - 编码器读取: 不受影响
    - 电池检测: 不受影响

  引脚兼容:
    - D5/D11新增SoftSerial功能，此前未使用，无冲突
    - 其余引脚分配不变

================================================================================
四、已知问题
================================================================================

  1. SoftwareSerial在9600bps下接收可能因Timer2中断导致字符丢失
     若出现遥控指令丢失，可尝试将UART波特率降至4800
     或将SoftSerial RX引脚改为支持PCINT的引脚

  2. 遥控器超时停车(500ms)后，若遥控器恢复发送指令，
     小车会立即恢复运动，无渐启动保护
     建议后续版本增加速度渐增(ramp-up)机制

  3. 编码器回传数据每200ms发送一次，在SoftSerial发送期间
     可能短暂影响接收解析，但影响极小(9600bps下约10ms)

  4. 三种控制模式切换时未做状态清理(如PID积分项清零)，
     从遥控器模式切换到其他模式时可能出现短暂的速度跳变

================================================================================
