GeorgeCao-001/Robotics-from-Scratch/arduino/logs/changelog/2026-05-12/remote_controller.md

================================================================================
  ESP32-S3 遥控器固件 - 每日更新日志
================================================================================

项目名称: ESP32-S3 遥控器固件 (remote_controller)
版本号:   v2.0.0
更新日期: 2026-05-12

================================================================================
一、主要更新内容
================================================================================

【新增功能】
  - 左摇杆Y轴重新定义为速度控制杆，前推前进、后拉后退、居中停止
  - 右摇杆X轴重新定义为方向控制杆，左推左转、右推右转、居中直行
  - 模式按键支持手动控制/自动运行切换，自动模式下摇杆输入被忽略
  - 新增FLAG_AUTO_MODE标志位(bit0)，用于通知小车端切换运行模式
  - 新增StatusPacket校验和验证，提升状态回传数据可靠性

【优化项】
  - 数据包从9字节精简为6字节，减少ESP-NOW传输开销
    移除字段: ptzPan, ptzTilt, speedLevel
    保留字段: header, type, velocity, turn, flags, checksum
  - 速度控制从"档位×摇杆偏移"改为"摇杆偏移直接映射"，操控更直觉
  - 校验和计算范围从8字节调整为5字节，适配新包结构
  - LED状态指示增加自动模式慢闪(800ms)区分
  - 移除蜂鸣器相关代码，减少GPIO占用

【移除功能】
  - 移除云台Pan/Tilt控制功能及相关代码
  - 移除急停按键(BTN_ESTOP)及estopActive逻辑
  - 移除加速/减速按键(BTN_SPEED_UP/BTN_SPEED_DN)及speedLevel变量
  - 移除左摇杆SW按键(云台使能切换)及ptzEnabled变量
  - 移除右摇杆SW按键及Y轴读取(JOY_R_VRY)
  - 移除左摇杆X轴读取(JOY_L_VRX)
  - 移除FLAG_ESTOP、FLAG_PTZ_EN标志位定义
  - 移除BUZZER_PIN引脚定义及蜂鸣器驱动代码

================================================================================
二、影响范围
================================================================================

  硬件影响:
    - 遥控器PCB/接线需重新调整，仅需2路ADC(左Y+右X)+1个按键+1个LED
    - 移除4个按键(急停/加速/减速/右摇杆SW)的接线
    - 移除蜂鸣器接线
    - 右摇杆仅需连接VRx和电源，VRy/SW可悬空
    - 左摇杆仅需连接VRy和电源，VRx/SW可悬空

  软件影响:
    - ESP32-C3接收器需同步更新至v2.0.0
    - Arduino UNO主程序需同步更新以适配新UART协议格式
    - ControlPacket结构体不兼容v1.x，两端必须同时升级

  通信影响:
    - ESP-NOW数据包格式变更(9字节→6字节)，与v1.x不兼容
    - UART协议格式变更(移除S字段)，与v1.x不兼容

================================================================================
三、兼容性说明
================================================================================

  向后兼容: 不兼容v1.x
    - 数据包结构变更，v2.0与v1.x无法互通
    - 必须将遥控器、接收器、Arduino主程序全部升级至v2.0

  硬件兼容:
    - ESP32-S3 DevKitC: 完全兼容
    - KY-023摇杆模块: 兼容(仅需单轴)
    - 轻触按键: 兼容(仅需1个)

  协议兼容:
    - ESP-NOW通道: 保持通道1不变
    - UART波特率: 保持9600不变
    - MAC地址配置方式: 不变

================================================================================
四、已知问题
================================================================================

  1. 自动模式下遥控器发送vel=0/turn=0，若小车端未正确解析flags
     可能导致小车停止而非进入演示模式，需确认Arduino端已同步更新

  2. 摇杆居中时存在±8的死区，极低速微调可能不够精细
     可通过调整JOYSTICK_DEADZONE参数优化

  3. 自动模式切换依赖单次按键触发，无防误触二次确认机制
     建议后续版本增加按键长按或双击确认

  4. 遥控器断连后小车端依赖心跳超时停车(1000ms)，
     该时间段内小车可能继续运动，需注意安全

================================================================================
