GeorgeCao-001/Robotics-from-Scratch/arduino/logs/changelog/2026-05-13/car_receiver.md

================================================================================
  ESP32-C3 小车端接收器固件 - 每日更新日志
================================================================================

项目名称: ESP32-C3 小车端接收器固件 (car_receiver)
版本号:   v2.0.1
更新日期: 2026-05-13

================================================================================
一、主要更新内容
================================================================================

【修复的问题】
  - 修正v2.0.0更新日志中的错误记录
    原日志错误声明"移除BATT_ADC_PIN电池检测引脚(GPIO0)及相关代码"
    实际代码中BATT_ADC_PIN、checkBattery()、batteryVoltage均完整保留
    电池电压检测功能正常运行，每2秒采样一次并通过StatusPacket回传

【验证通过项】
  - 心跳包时间戳更新逻辑验证通过
    onRecv()回调中lastRemoteTime和remoteOnline更新位于
    pkt.type判断之前，PKT_CTRL和PKT_HEARTBEAT均会更新连接状态
    不存在"心跳包未更新连接时间戳"的问题

  - 校验和计算风格已统一使用sizeof() - 1
    car_receiver端所有calcChecksum调用均使用此模式，无需修改

================================================================================
二、影响范围
================================================================================

  代码影响: 无代码变更，仅修正日志记录

  功能影响: 无
    - 电池检测功能正常运行
    - 心跳超时检测正常运行
    - 校验和计算正常运行

================================================================================
三、兼容性说明
================================================================================

  与v2.0.0完全一致，无变更

================================================================================
四、已知问题
================================================================================

  (继承v2.0.0已知问题，无新增)

  1. readFromArduino()仍使用String.readStringUntil()阻塞读取
  2. batteryVoltage默认值12.0V，但实际ADC检测功能正常工作
  3. 心跳超时停车后不会自动恢复

================================================================================
