GeorgeCao-001/Robotics-from-Scratch/arduino/logs/changelog/2026-05-16/main_controller.md

================================================================================
  Arduino UNO 两驱小车控制程序 - 每日更新日志
================================================================================

项目名称: Arduino UNO 两驱小车控制程序 (Arduino_TB6612_TwoWheel_Car)
版本号:   v2.4.0
更新日期: 2026-05-16

================================================================================
一、主要更新内容
================================================================================

【新增功能】

  1. 新增树莓派自动模式 (CTRL_MODE_RPI_AUTO = 3)
     - 系统从三模式升级为四模式控制系统:
       演示模式(0) / 串口命令模式(1) / 遥控器模式(2) / 树莓派自动模式(3)
     - 自动模式下Arduino仅响应树莓派JSON指令，忽略遥控器摇杆数据
     - 遥控器模式键仍可在自动模式下切换回遥控器模式（安全接管）

  2. 新增JSON指令解析函数 parseRpiCommand()
     - 支持四种指令类型:
       · {"cmd":"move","v":0.3,"w":0.1}   — 运动控制
       · {"cmd":"mode","mode":"rpi_auto"}  — 切换到自动模式
       · {"cmd":"mode","mode":"remote"}    — 切换到遥控器模式
       · {"cmd":"estop"}                   — 紧急停车并切回遥控器模式
       · {"cmd":"stop"}                    — 停车（不切换模式）
     - v/w归一化值映射到Arduino速度/转向脉冲:
       velocity = v × REMOTE_SPEED_MAX (40脉冲/5ms)
       turn = w × DEFAULT_TURN (18脉冲/5ms)
     - 所有输入值经constrain()限幅到[-1.0, 1.0]范围
     - 内置200ms打印节流，避免串口输出影响实时性

  3. 新增JSON缓冲区机制
     - 64字节缓冲区 rpiBuf[RPI_CMD_MAX_LEN]
     - 逐字符接收，遇到'\n'完成一条指令
     - 缓冲区溢出时自动清零丢弃，防止内存越界
     - 仅在CTRL_MODE_RPI_AUTO模式下解析JSON，其他模式仅处理单字符命令

  4. 新增树莓派超时检测函数 checkRpiTimeout()
     - 超时阈值: RPI_CMD_TIMEOUT = 1000ms
     - 超时后执行moveStop()停车
     - 不切换模式，允许树莓派恢复后自动继续控制
     - 仅在rpiAutoActive=true时检测

  5. 新增多层失控急停保护（6层）
     | 保护层 | 触发条件 | 响应 | 恢复方式 |
     |--------|---------|------|---------|
     | 树莓派超时急停 | 1000ms未收到指令 | moveStop() | 自动恢复 |
     | 视觉丢失停车 | 0.8s未检测到人体 | 停车指令 | 自动恢复 |
     | 遥控器急停 | 遥控器模式键 | 切换到遥控器模式 | 手动切回 |
     | USB串口急停 | 空格键/estop指令 | 停车+切回遥控器 | 手动切回 |
     | 树莓派退出 | Ctrl+C/异常 | finally块停车+切回 | 遥控器立即可用 |
     | 树莓派断电 | USB断开/断电 | 1秒超时停车 | 遥控器模式键接管 |

【修复的问题】

  1. 修复遥控模式左右转向方向与操作相反的问题
     - 在applyRemoteDrive()中添加 steerPercent = -steerPercent
     - 原因: 遥控器摇杆映射的转向百分比与差速驱动的转向方向定义相反
     - 修复后: 摇杆向左→小车左转，摇杆向右→小车右转

  2. 修复遥控模式转向速度过快的问题
     - 将REMOTE_TURN_PWM_MAX从200降低到80
     - 转向PWM上限(80)远低于驱动PWM上限(220)
     - 限制原地转向的最大速度，确保转向平稳可控

  3. 修复遥控器模式键切换自动模式的目标模式错误
     - 原代码: 遥控器请求自动模式时切换到CTRL_MODE_DEMO
     - 修正为: 切换到CTRL_MODE_RPI_AUTO
     - 同时设置rpiAutoActive=true并记录lastRpiCmdTime

【优化项】

  - handleSerialCommand()重构为双通道处理:
    单字符命令('M','R','P',' ')和JSON指令自动分流
  - parseRemoteCommand()新增CTRL_MODE_RPI_AUTO分支
  - 模式切换时统一执行moveStop()，避免旧PWM状态残留
  - printCtrlMode()新增"树莓派自动"输出
  - loop()主循环中增加checkRpiTimeout()调用

================================================================================
二、影响范围
================================================================================

  运动控制影响:
    - 遥控模式转向方向与操作直觉一致
    - 遥控模式转向速度平稳可控
    - 新增树莓派自动模式下的运动控制通道

  模式管理影响:
    - 系统支持四种控制模式，模式切换仅由显式请求触发
    - 自动模式下遥控器摇杆数据被忽略，但模式键仍可安全接管
    - 树莓派超时停车不切换模式，允许自动恢复

  通信协议影响:
    - USB串口新增JSON指令协议（与单字符命令共存）
    - 树莓派通过USB CDC虚拟串口与Arduino通信（115200bps）
    - JSON指令以'\n'为分隔符，紧凑格式减少传输延迟

================================================================================
三、兼容性说明
================================================================================

  与ESP32-C3接收器兼容: 完全兼容v2.0.x/v2.1.x
    - 接收器仅转发UART字符串，无需感知JSON指令语义

  与ESP32-S3遥控器兼容: 完全兼容v2.1.0
    - 遥控器模式键可在自动模式下安全接管
    - 摇杆数据在自动模式下被忽略，不影响运动控制

  与树莓派4B兼容: 需配套raspberry_pi/代码使用
    - 树莓派通过USB串口发送JSON指令
    - 启动时发送mode:rpi_auto，退出时发送mode:remote

  向后兼容:
    - USB串口单字符命令('M','R','P',' ')保持兼容
    - 演示模式、串口命令模式、遥控器模式行为不变

================================================================================
四、已知问题
================================================================================

  1. SoftwareSerial在9600bps下接收仍可能受Timer2中断影响出现字符丢失

  2. JSON缓冲区仅64字节，超长指令会被截断丢弃
     当前最长的estop指令约20字节，64字节余量充足

  3. parseRpiCommand()使用strstr()简易解析，不支持嵌套JSON
     当前指令格式均为扁平结构，无需嵌套解析

  4. 遥控模式下直接PWM输出尚未增加渐启动/渐停(ramp)保护

================================================================================
五、关键代码变更清单
================================================================================

  新增定义:
    #define CTRL_MODE_RPI_AUTO 3
    #define RPI_CMD_MAX_LEN   64
    #define RPI_CMD_TIMEOUT   1000

  新增全局变量:
    char rpiBuf[RPI_CMD_MAX_LEN]
    uint8_t rpiBufIdx
    unsigned long lastRpiCmdTime
    bool rpiAutoActive

  新增函数:
    void parseRpiCommand(const char *json)
    void checkRpiTimeout()

  修改函数:
    void handleSerialCommand()      — 双通道: 单字符 + JSON
    void applyRemoteDrive()         — 转向方向反转 + PWM上限调整
    void parseRemoteCommand()       — 新增RPI_AUTO模式分支
    void printCtrlMode()            — 新增"树莓派自动"输出
    void loop()                     — 新增checkRpiTimeout()调用

  修改常量:
    REMOTE_TURN_PWM_MAX: 200 → 80

================================================================================
