GeorgeCao-001/Robotics-from-Scratch/arduino/logs/changelog/2026-05-16/remote_and_receiver.md

================================================================================
  遥控器与接收器 - 每日更新日志
================================================================================

项目名称: ESP32-S3 遥控器固件 / ESP32-C3 小车端接收器固件
版本号:   遥控器 v2.1.0 / 接收器 v2.0.2
更新日期: 2026-05-16

================================================================================
一、验证通过项
================================================================================

  1. 遥控器模式键在树莓派自动模式下的安全接管功能验证通过
     - 在CTRL_MODE_RPI_AUTO模式下，按下遥控器模式键
     - Arduino正确切换到CTRL_MODE_REMOTE模式
     - 遥控器摇杆数据恢复控制权
     - 验证依据: parseRemoteCommand()中CTRL_MODE_RPI_AUTO分支正确处理

  2. 遥控器摇杆数据在自动模式下被正确忽略
     - CTRL_MODE_RPI_AUTO模式下，loop()不调用applyRemoteDrive()
     - 摇杆数据不会干扰树莓派的运动控制指令
     - 验证依据: loop()中ctrlMode判断逻辑

  3. 接收器对新增JSON指令的透明转发验证通过
     - JSON指令通过USB串口直接到达Arduino，不经过ESP-NOW/UART链路
     - 接收器无需感知JSON指令语义
     - 验证依据: 树莓派与Arduino通过USB直连，不经过接收器

================================================================================
二、代码变更
================================================================================

  (无代码变更)

  遥控器和接收器固件今日未做任何代码修改。
  现有v2.1.0/v2.0.2版本完全兼容树莓派自动模式集成。

================================================================================
三、兼容性说明
================================================================================

  与Arduino主控v2.4.0兼容: 完全兼容
    - 遥控器模式键可在自动模式下安全接管
    - 摇杆数据在自动模式下被忽略

  与树莓派自动模式兼容: 完全兼容
    - 树莓派通过USB串口直连Arduino，不经过ESP-NOW链路
    - 接收器/遥控器与树莓派通信链路无交集

================================================================================
四、已知问题
================================================================================

  (继承v2.1.0/v2.0.2已知问题，无新增)

================================================================================
