GeorgeCao-001/Robotics-from-Scratch/arduino/logs/changelog/2026-05-14/main_controller.md

================================================================================
  Arduino UNO 两驱小车控制程序 - 每日更新日志
================================================================================

项目名称: Arduino UNO 两驱小车控制程序 (Arduino_TB6612_TwoWheel_Car)
版本号:   v2.2.0
更新日期: 2026-05-14

================================================================================
一、主要更新内容
================================================================================

【新增功能】
  - 新增FLAG_MODE_SWITCH_REQUEST(bit1)显式模式切换协议支持
    parseRemoteCommand()仅在检测到用户切换请求时才更新ctrlMode，
    普通摇杆控制包不再承担模式切换职责

  - 新增遥控模式下的直接PWM混控输出
    新增applyRemoteDrive()、setDirectPwmDrive()等逻辑，
    将速度/转向百分比直接线性混控到左右轮PWM输出

【修复的问题】
  - 修复parseRemoteCommand()中局部变量turn遮蔽全局turn的问题
    原实现中turn = map(turn, ...)实际使用的是局部变量，
    导致转向值未正确写入全局控制量，左右转向无法稳定执行

  - 修复收到普通手动控制包时自动切回REMOTE模式的问题
    原逻辑在检测到遥控数据后会自动设置ctrlMode = CTRL_MODE_REMOTE，
    现已删除该自动状态流转，仅保留用户显式触发的模式切换

  - 修复遥控模式速度调节失效的问题
    遥控模式改为速度PWM与转向PWM线性叠加，
    恢复摇杆前后位移与电机输出之间的连续变速关系

  - 修复中立区附近仍可能维持输出的问题
    遥控输入增加独立死区判断，速度与转向同时落入死区时直接停车

【优化项】
  - PI控制器内部状态从函数静态变量调整为全局变量，resetPIController()可直接清零
  - 自动模式切换前先执行moveStop()，避免旧PWM状态残留
  - 直接PWM输出同步写入motorPwmA/motorPwmB，便于状态打印与回传对齐
  - 初始化提示修正为默认遥控器模式，与实际ctrlMode初始值保持一致

================================================================================
二、影响范围
================================================================================

  运动控制影响:
    - 左右转向触发恢复正常
    - 摇杆前后推拉可直接控制速度变化
    - 中立区停车更稳定，误动作概率下降

  模式管理影响:
    - 系统不再因普通遥控包自动切回手动遥控模式
    - 手动/自动切换仅由串口'M'命令或遥控器模式键显式触发

  协议影响:
    - 需识别flags.bit1作为模式切换请求位
    - 建议遥控器同步升级至v2.1.0，确保自动模式退出后可手动切回遥控模式

================================================================================
三、兼容性说明
================================================================================

  与ESP32-C3接收器兼容: 完全兼容v2.0.0/v2.0.1
    - 接收器仅转发UART字符串，无需感知新增协议语义

  与ESP32-S3遥控器兼容:
    - 建议配套v2.1.0使用，以支持显式模式切换请求
    - 若遥控器仍为v2.0.x，普通摇杆控制仍可工作，
      但自动模式退出后无法通过旧协议可靠切回手动遥控模式

  向后兼容:
    - USB串口命令控制与演示模式保持兼容
    - 遥控协议需按v2.1.0语义理解flags字段

================================================================================
四、已知问题
================================================================================

  1. SoftwareSerial在9600bps下接收仍可能受Timer2中断影响出现字符丢失

  2. 遥控模式下直接PWM输出尚未增加渐启动/渐停(ramp)保护

  3. 编码器回传发送期间仍可能对SoftwareSerial接收造成短时干扰

================================================================================
五、v2.2.0 追加更新 (2026-05-14)
================================================================================

【修复的问题】
  - 修正引脚定义注释中"四路TB6612"和"两颗TB6612FNG芯片"的错误描述
    实际硬件为单颗TB6612FNG芯片提供A口+B口两个电机端口，
    原注释误写为"四路"和"Chip1+Chip2"架构

  - 将所有D口命名统一修正为B口
    右电机实际连接模块B口，但代码变量/函数/注释中错误使用了D口命名:
      targetSpeedD  → targetSpeedB
      motorPwmD     → motorPwmB
      piBiasD       → piBiasB
      piLastBiasD   → piLastBiasB
      piPwmD        → piPwmB
      incrementalPI_D → incrementalPI_B
    涉及变量声明、PI控制函数、运动学分析、状态打印、编码器回传等位置

【优化项】
  - 引脚定义注释从"WHEELTEC 四路TB6612 电机驱动模块"更正为
    "TB6612 双路电机驱动模块 (A口+B口)"
  - 运动学分析注释从"Target_D"更正为"Target_B"
  - 状态打印标签从"目标速度D/编码器D/PWM输出D"更正为
    "目标速度B/编码器B/PWM输出B"

================================================================================
六、v2.3.0 追加更新 (2026-05-14)
================================================================================

【新增功能】
  - 编码器升级为A/B双相方向检测
    新增ENCODER_LEFT_B(A4)和ENCODER_RIGHT_B(A5)引脚定义，
    ISR中在A相上升沿读取B相电平判断转向:
      B=LOW → 正转(count++)
      B=HIGH → 反转(count--)

【修复的问题】
  - 修正ENCODER_PPR注释与实际计数方式不一致
    原注释"4倍频后=44"但代码仅用A相上升沿(1倍频)，
    现修正为ENCODER_PPR=11 (A相上升沿计数)
    注: 此宏当前未参与控制循环计算，不影响PI行为

【优化项】
  - 文件头电机接口描述从"5线"更新为"6线"
  - setup()中新增B相引脚INPUT_PULLUP初始化

================================================================================
