GeorgeCao-001/Robotics-from-Scratch/arduino/logs/changelog/2026-05-13/main_controller.md

================================================================================
  Arduino UNO 两驱小车控制程序 - 每日更新日志
================================================================================

项目名称: Arduino UNO 两驱小车控制程序 (Arduino_TB6612_TwoWheel_Car)
版本号:   v2.0.1
更新日期: 2026-05-13

================================================================================
一、主要更新内容
================================================================================

【验证通过项】
  - 遥控器指令解析逻辑验证通过，无代码变更
  - 自动模式切换(flags & 0x01)功能正常
  - SoftwareSerial通信与PID控制共存无冲突

================================================================================
二、影响范围
================================================================================

  无代码变更

================================================================================
三、兼容性说明
================================================================================

  与v2.0.0完全一致，无变更

================================================================================
四、已知问题
================================================================================

  (继承v2.0.0已知问题，无新增)

  1. SoftwareSerial在9600bps下接收可能因Timer2中断导致字符丢失
  2. 遥控器超时停车后恢复运动无渐启动保护
  3. 编码器回传可能短暂影响接收解析
  4. 模式切换时未做PID积分项清零

================================================================================
