GeorgeCao-001/Robotics-from-Scratch/arduino/logs/changelog/2026-05-13/remote_controller.md

================================================================================
  ESP32-S3 遥控器固件 - 每日更新日志
================================================================================

项目名称: ESP32-S3 遥控器固件 (remote_controller)
版本号:   v2.0.1
更新日期: 2026-05-13

================================================================================
一、主要更新内容
================================================================================

【修复的问题】
  - 修复校验和计算使用硬编码长度5的问题
    buildControlPacket()中 calcChecksum((uint8_t *)&txPacket, 5)
    改为 calcChecksum((uint8_t *)&txPacket, sizeof(txPacket) - 1)
    原硬编码值5在功能上正确(6字节结构体前5字节为校验范围)，
    但若未来结构体增减字段会导致校验和计算错误且难以排查

  - 修复心跳包校验和同样使用硬编码长度5的问题
    sendHeartbeat()中 calcChecksum((uint8_t *)&hb, 5)
    改为 calcChecksum((uint8_t *)&hb, sizeof(hb) - 1)

【优化项】
  - 校验和计算风格与接收器端(car_receiver)统一，
    全项目所有calcChecksum调用均使用sizeof() - 1模式

================================================================================
二、影响范围
================================================================================

  运行时影响: 无
    - sizeof(ControlPacket) = 6, sizeof() - 1 = 5
    - 修改前后计算结果完全一致，不影响通信兼容性

  代码维护性影响: 正面
    - 未来ControlPacket结构体变更时校验和自动适配
    - 全项目校验和调用风格统一，降低维护风险

================================================================================
三、兼容性说明
================================================================================

  通信兼容: 与v2.0.0完全兼容
    - 校验和计算结果不变，ESP-NOW数据包格式不变
    - 可与v2.0.0接收器正常通信

  向后兼容: 与v1.x不兼容 (继承v2.0.0的不兼容性)

================================================================================
四、已知问题
================================================================================

  (继承v2.0.0已知问题，无新增)

  1. 自动模式下遥控器发送vel=0/turn=0，若小车端未正确解析flags
     可能导致小车停止而非进入演示模式
  2. 摇杆居中死区±8，极低速微调可能不够精细
  3. 自动模式切换无防误触二次确认机制
  4. 遥控器断连后小车端依赖心跳超时停车(1000ms)

================================================================================
