GeorgeCao-001/Robotics-from-Scratch/(commit log)

2026-03-24 加入了arduino uno键控小车和云台的模块，以及gazebo仿真。其他详见readme
    [car.urdf]
2026-04-04 feat: raspberry_pi hardware module
2026-04-04 fix: hardware restriction params
    [main.py, serial_comm.py]
2026-05-12 feat: 新增TB6612两驱小车完整项目文件
    新增了Arduino控制代码、接线指导文档、MG513电机接线指南、ESP32遥控器与接收器固件及完整的遥控器系统接线指南，实现了带ESP-NOW无线遥控的两驱小车完整方案
2026-05-12 fix: adapt CV to raspberry pi env
    [main.py]
2026-05-13 chore: release v2.0.1 并更新项目日志与文档
    1. 新增并完善2026-05-13的各模块更新日志
    2. 合并冗余接线指导文档至主接线指南并更新标题
    3. 优化Arduino主程序遥控协议，移除速度档位与S字段
    4. 统一全项目校验和计算使用sizeof()-1模式
    5. 修复遥控器固件校验和硬编码长度问题
    6. 新增日志轮转策略与配置文件
    7. 删除冗余的接线指导.md文件与旧版工程文件
    [Arduino_TB6612_TwoWheel_Car.ino, car_receiver.ino, remote_controller.ino]
2026-05-13 fix: align gimbal behaviour to README.md
    [gimbal.py, main.py, serial_comm.py]
2026-05-14 docs: gimbal camera debug log
2026-05-14 feat: 完成v2.1.0版本全量更新
    - 升级遥控器固件v2.1.0，新增摇杆自动校准、模式切换请求标志位，修复摇杆中立漂移问题
    - 升级主控固件v2.1.0，重构遥控模式PWM混控逻辑，修复模式切换与转向控制bug，新增直接PWM输出
    - 修正接收器ESP-NOW回调参数与MAC地址配置，新增状态打印功能
    - 更新所有文档与接线指南，修正协议flags定义、电机接线与引脚配置
    - 新增完整更新日志与变更说明
    [Arduino_TB6612_TwoWheel_Car.ino, car_receiver.ino, remote_controller.ino]
2026-05-14 fix: 修正TB6612驱动右电机变量命名与协议描述
    统一将代码、文档中右电机的D口命名修正为B口，对齐硬件实际引脚定义和UART回传协议格式，更新版本号与变更日志
2026-05-14 feat: 升级编码器为A/B双相方向检测功能
    本次更新将编码器从单A相计数升级为支持方向检测的双相方案，新增B相引脚读取实现正反转计数，修正了原注释与实际计数方式不一致的问题，同时更新了所有相关文档和配置。
    主要变更：
    1. 新增ENCODER_LEFT_B(A4)和ENCODER_RIGHT_B(A5)引脚定义
    2. 修改编码器中断服务程序，通过B相电平判断转向
    3. 修正ENCODER_PPR参数为11并更新注释
    4. 在setup()中初始化B相引脚为上拉输入
    5. 更新所有接线文档、引脚说明和 changelog 记录
    [Arduino_TB6612_TwoWheel_Car.ino]
2026-05-16 fix: adapt gimbal control logic to hardware
    [gimbal.py, main.py]
2026-05-16 chore(arduino_uno_car): remove entire PlatformIO project directory
    删除了整个arduino_uno小车的PlatformIO开发项目文件，包括配置文件、源码、依赖文档和gitignore规则等无用的遗留工程文件。
2026-05-16 fix: gimbal 啊啊啊啊
2026-05-18 fix: replace RPi.GPIO with pigpio & params fine-tuning
    [gimbal.py, main.py]
2026-05-18 fix: fifo + nonblock & feat: I control + params fine-tuning
    [face_follow_test.py]
2026-05-19 feat(raspberry_pi): 新增树莓派视觉跟随完整系统
    新增树莓派端全套视觉跟随代码，包含串口通信、云台控制、运动规划、视觉检测模块，配套完善的测试用例与日志文档，实现人体检测自动跟随与云台对准功能。
2026-05-19 refactor: 重构树莓派代码目录结构，统一项目代码位置
    本次提交将原本分散在arduino/Arduino_TB6612_TwoWheel_Car/raspberry_pi/下的所有业务代码、测试文件、文档以及视觉模型文件，迁移到根目录下的raspberry_pi/目录中，删除了重复冗余的子目录结构，同时清理了不再需要的旧目录文件。
2026-05-19 chore: 清理树莓派项目中废弃的视觉与控制模块代码
    本次提交删除了所有不再使用的视觉模型文件、规划控制模块、硬件驱动代码以及配套的测试文件和文档，包括：
    1. 人脸/手部/姿态检测的模型文件与实现代码
    2. 云台控制、运动规划的核心逻辑代码
    3. 串口通信硬件驱动
    4. 全部单元测试与集成测试文件
    5. 项目文档AGENTS.md
2026-05-19 fix(two-wheel-car): 调整树莓派指令超时时间并修复遥控逻辑
    1. 将RPI_CMD_TIMEOUT从1000ms调整为3000ms
    2. 修正parseRemoteCommand中的模式切换逻辑错误
    3. 调整遥控指令解析时的字符串偏移量适配新格式
    4. 优化遥控超时处理：仅在遥控模式下才自动停车
    [Arduino_TB6612_TwoWheel_Car.ino]
2026-05-20 arduino status
2026-05-20 fix(tb6612车控): 修复RPI指令解析的潜在空指针风险
    优化指令解析逻辑，先查找冒号再提取参数值，避免直接偏移指针导致的非法内存访问
2026-05-21 fix(arduino): 修正增量PI偏差计算方向并完善停止逻辑
    1. 修正两个电机的增量PI偏差计算，改为目标值减实际值，符合常规PID偏差定义
    2. 优化moveStop函数执行顺序，先设置停止标志再重置PI控制器和输出PWM，避免残留积分导致的电机突然启动
    3. 停止时调用resetPIController清零积分项，并立即输出0占空比到电机
    [Arduino_TB6612_TwoWheel_Car.ino]
2026-05-31 chores: rearrangement
    [car.urdf]
